abe-kanofsky/ESP8266HoseControl/schematic.png

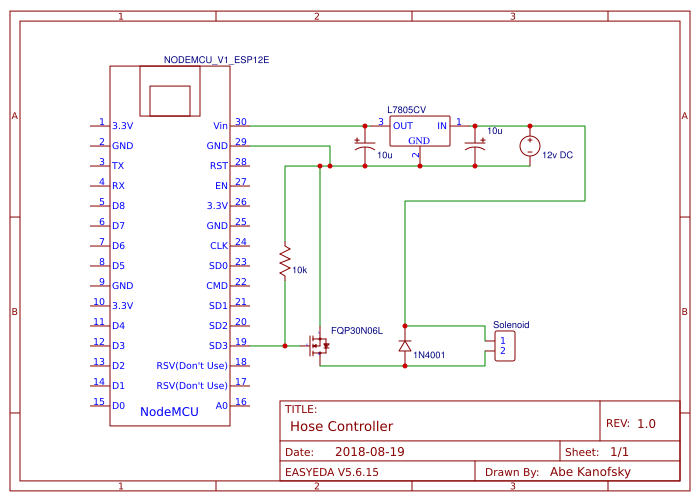
schematic.png
