abe-kanofsky/ESP8266HoseControl/src/weather.ino

/*
Provides ability to check the weather forecast using the OpenWeather API.
Copyright (C) 2018 Abe Kanofsky

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
You should have received a copy of the GNU General Public License
along with this program.  If not, see <https://www.gnu.org/licenses/>.
*/

// Forecast is obtained in 3-hour intervals.
const int intervals_to_check = days_to_check_weather * 8;

/*  Check forecast and update the will_rain variable. Assumes that
    weather_url a global variable, set to a valid url for the free
    OpenWeatherMap (including a valid API key). This function is set
    up to parse the 5-day/3-hour forecast, delivered in XML format.
     */
void update_weather() {
  HTTPClient http;
  http.begin(weather_url);
  int httpCode = http.GET();

  if (httpCode != 200) {
    return;
  }

  WiFiClient * stream = http.getStreamPtr();
  char buffer[64] = {};
  int len = http.getSize();
  float total_rain = 0;
  int intervals_checked = 0;

  while (http.connected() && (intervals_checked < intervals_to_check)) {
    if(stream->available()) {
      int c = stream->readBytesUntil('>', buffer, 64);
      if(strncmp(buffer, "<precipitation", 14) == 0) {
        intervals_checked++;
        char *value_ptr = strstr(buffer, "value=\"");
        if (value_ptr) {
          total_rain += atof(value_ptr + 7);
        }
      }
    }
    Alarm.delay(0);
  }
  http.end();

  will_rain = total_rain >= rain_limit;
  last_forecast = total_rain;
}

void set_weather_checking(bool en) {
  weather_checking = en;
  broadcast_checked("weather-enabled", en);

  EEPROM.write(EEPROM_weather_checking_addr, en);
  EEPROM.commit();
}
